Sim-59/ATtiny-DCC-Accessory-Decoder/hardware/ATtiny-MuFu4P_schematic_1.1.pdf

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

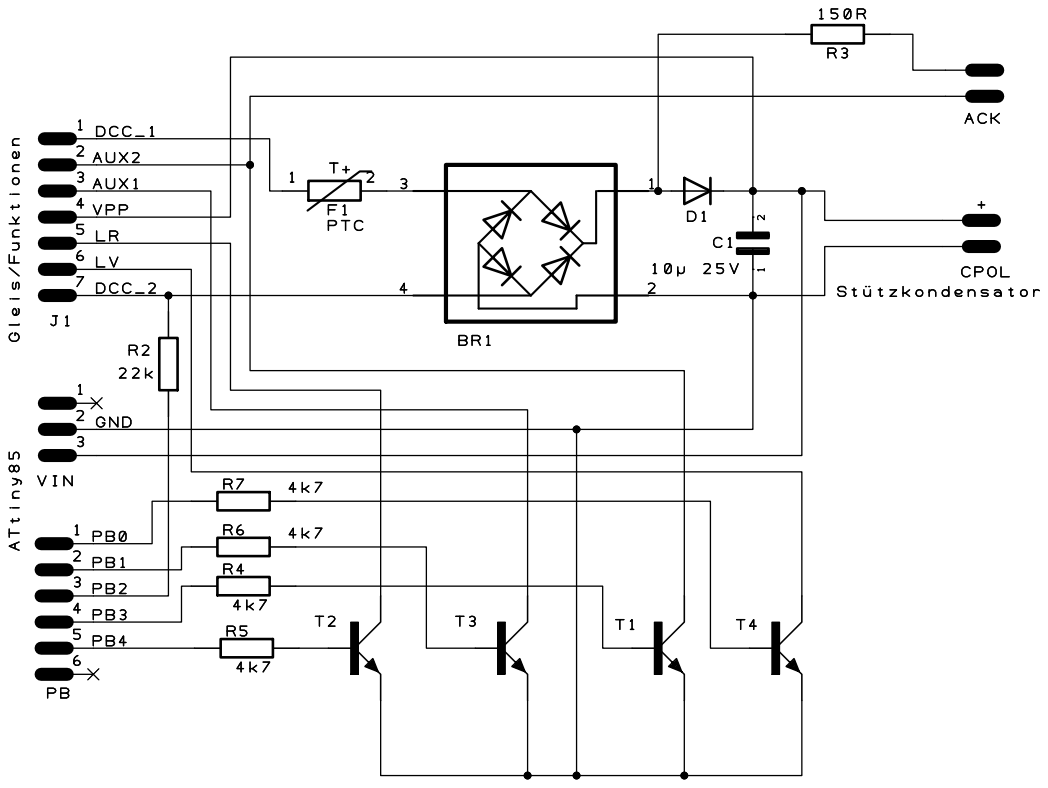
[picture p4: page 1]
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
