Sim-59/ATtiny-DCC-Accessory-Decoder/(commit log)

2026-03-30 Update README formatting and add Arduino reference
2026-04-14 Update project title to include 'Digispark-Board'
2026-04-15 Modify README title for accessory decoder
    Updated project title in README to remove 'Digispark-Board'.
2026-04-15 Fix comment typo in DCC_AccDecoder_4Ports.ino
    [DCC_AccDecoder_4Ports.ino]
2026-05-27 Update README with detailed hardware information
    Expanded hardware description for ATtiny85 Digispark Board.
2026-11-04 Update CV reading description in README.md
    Clarified CV reading process at programming track.
